realhuno/Chorus-RF-Laptimer/docs/img/radio.jpg

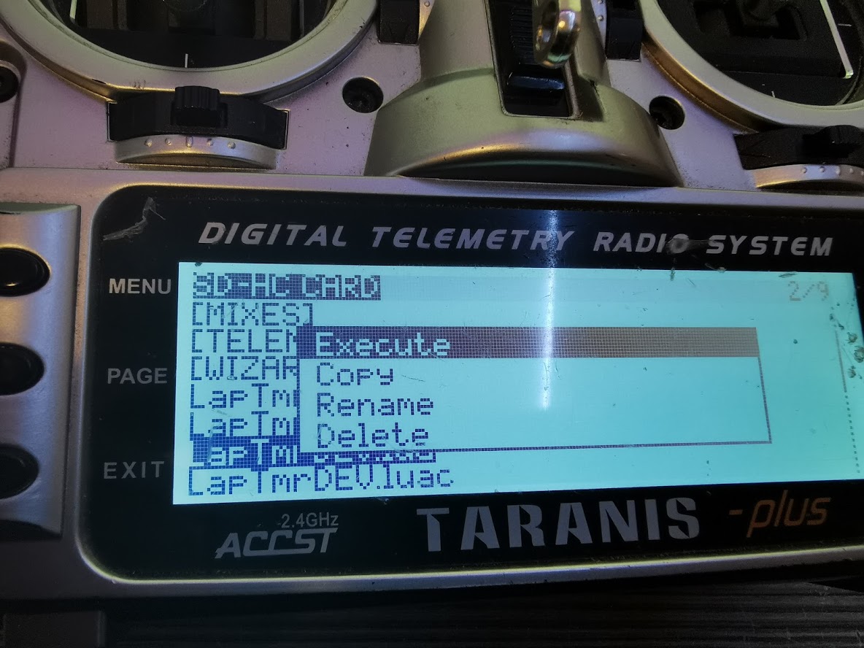
docs/img/radio.jpg
